jaromir-sukuba/micro_progmeter/README

repository for https://hackaday.io/project/7988-micro-progmeter
HW design files in cadsoft eagle 6 and higher

The whole project is licensed under MIT license, see LICENSE.md file.
