jaromir-sukuba/micro_progmeter/hw/mechanical/stl/4_main.stl

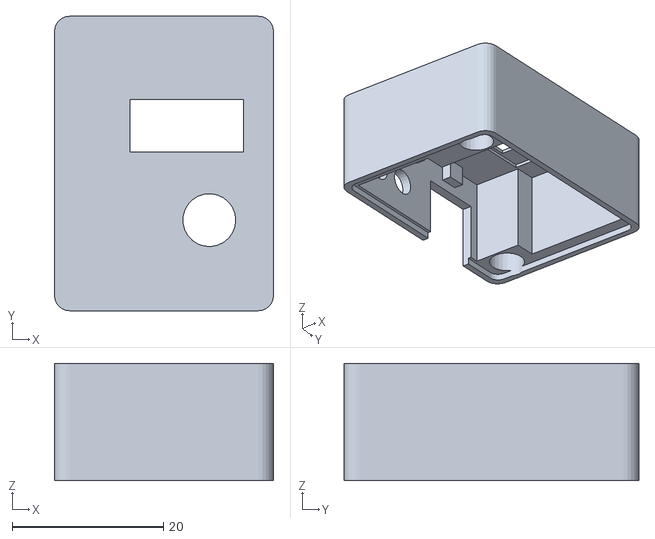
[picture p1: CAD file, 2015-12-22]
hw/mechanical/stl/4_main.stl
29.0 x 39.0 x 15.5
