jaromir-sukuba/micro_progmeter/hw/mechanical/freecad/4.fcstd

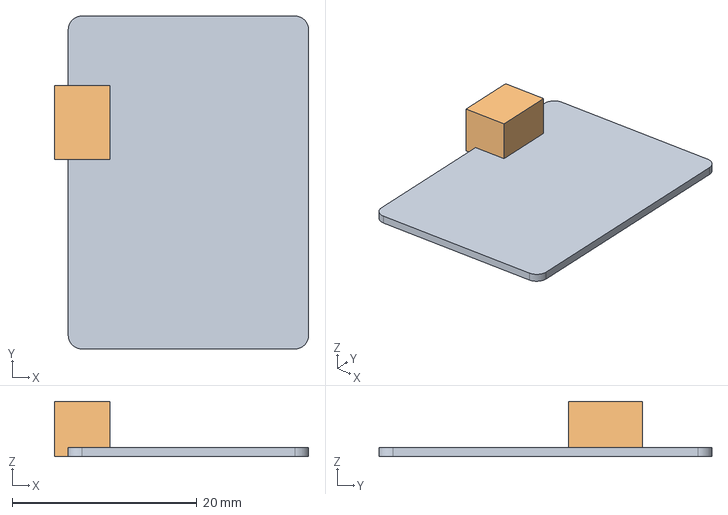
[picture p2: CAD file, 2015-12-22]
hw/mechanical/freecad/4.fcstd
27.5 x 36.0 x 6.00 mm
cover
cover_usb_ext
