jaromir-sukuba/micro_progmeter/hw/mechanical/freecad/4a.fcstd

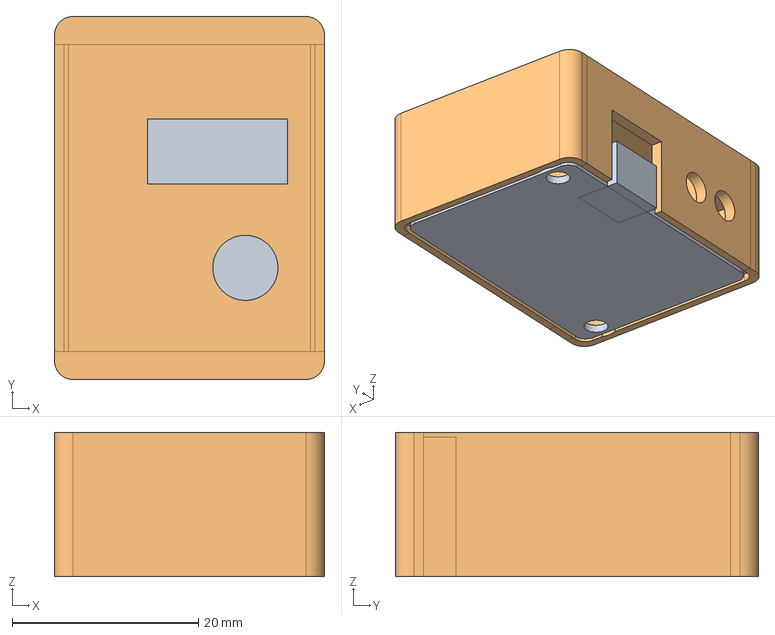
[picture p3: CAD file, 2015-12-22]
hw/mechanical/freecad/4a.fcstd
29.0 x 39.0 x 15.5 mm
cover_holes
main_holes
