jaromir-sukuba/micro_progmeter/hw/mechanical/stl/4_cover.stl

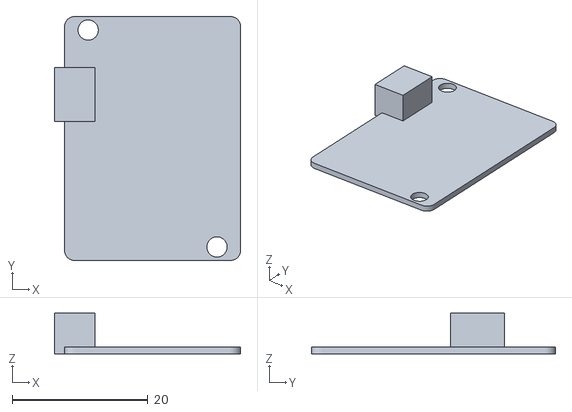
[picture p4: CAD file, 2015-12-22]
hw/mechanical/stl/4_cover.stl
27.5 x 36.0 x 6.00
