jaromir-sukuba/micro_progmeter/(list of files, cad)

Other CAD files:
fw/pmm_t1.X/l.obj
