jaromir-sukuba/micro_progmeter/hw/6e.sch.pdf

TC1015

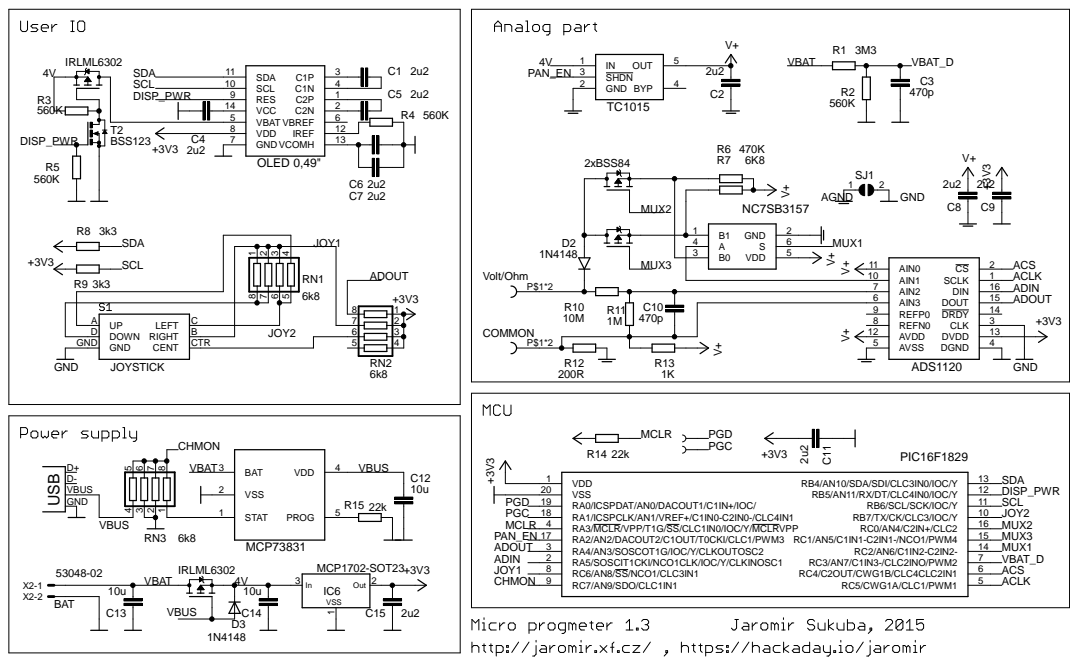
[picture p5: page 1]
