jaromir-sukuba/micro_progmeter/hw/6d.sch.pdf

TC1015

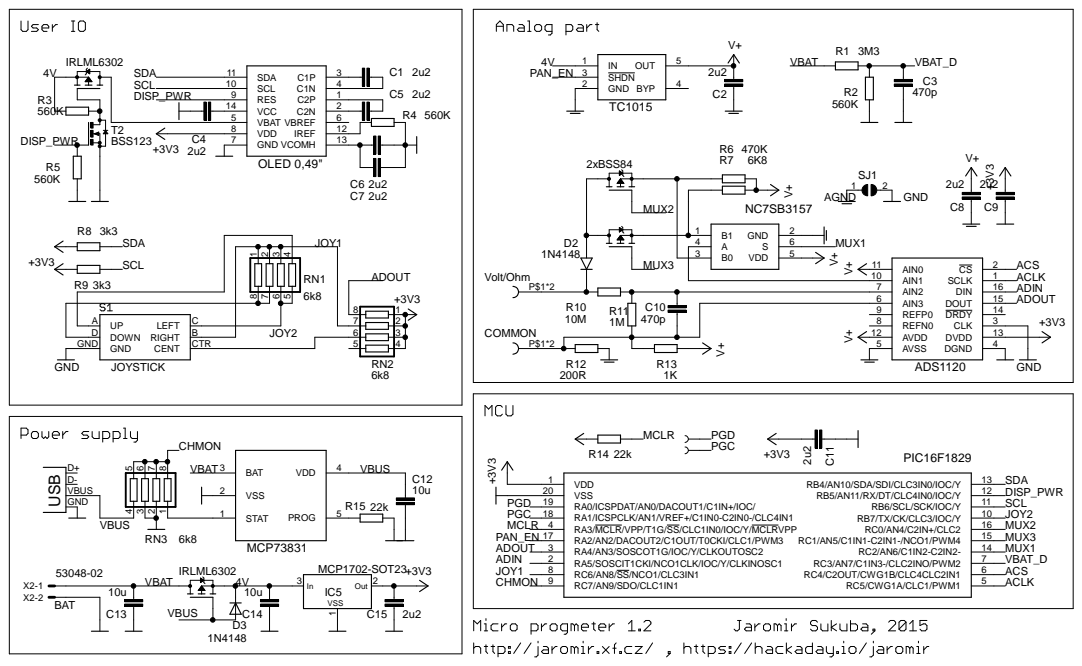
[picture p6: page 1]
