jaromir-sukuba/micro_progmeter/hw/6c.sch.pdf

TC1015

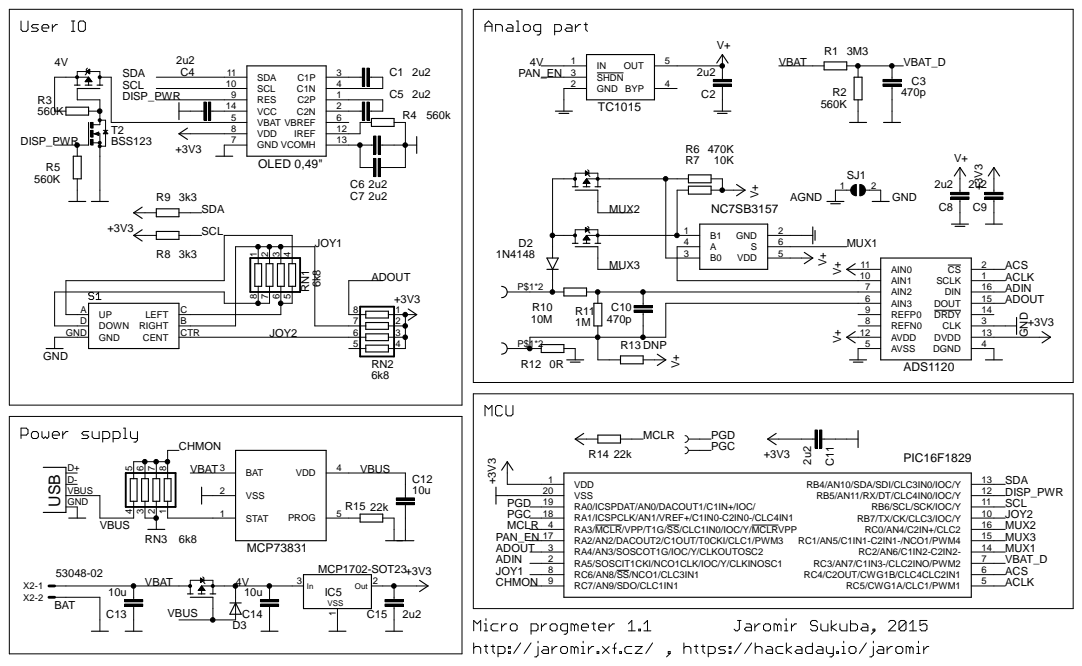
[picture p7: page 1]

VCC 14 | 2
