jaromir-sukuba/micro_progmeter/hw/5d.sch.pdf

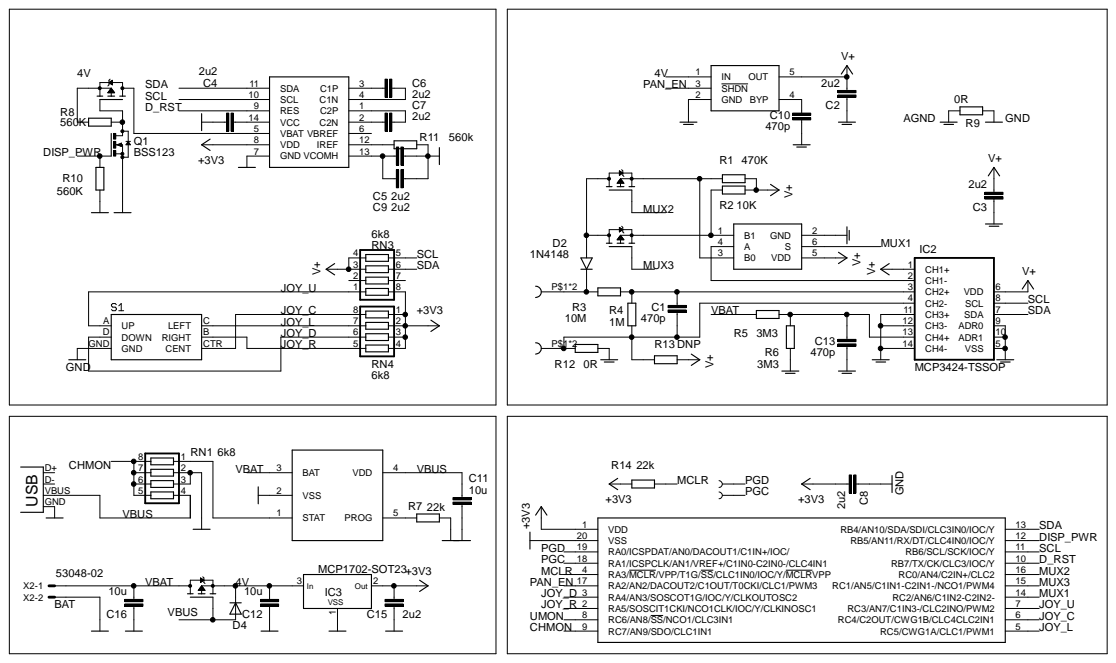
[picture p8: page 1]
