jaromir-sukuba/micro_progmeter/hw/eagle/6e.brd

## EAGLE design hw/eagle/6e.brd (2015-12-22)

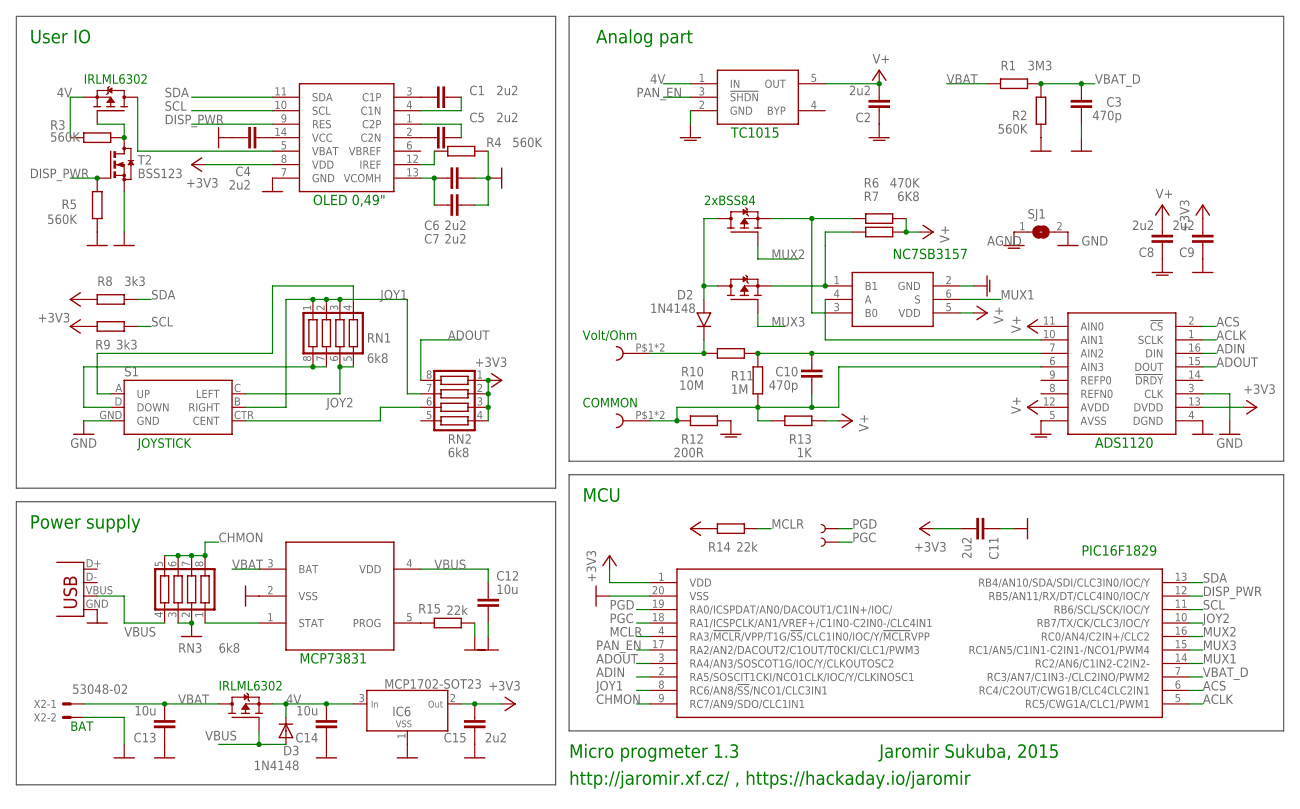
[picture p9: schematic 6e.sch]

Parts:
C1, C2, C4, C5, C6, C7, C8, C9, C11, C15: 2u2; 0603
C3, C10: 470p; 0603
C12, C13, C14: 10u; R0805
D1: DISP_OLED_049B; DISP_OLED_049_B
D2: 1N4148; SOD-80
D3: 1N4148; SOD123
IC1: TC1015; SOT23-5
IC2: NC7SB3157; SC70-6
IC3: ADS1120; TSSOP16
IC4: MCP73831; SOT23-5
IC5: PIC16F1508SSOP20; SSOP20
IC6: MCP1702-SOT23; SOT23
R1: 3M3; 0603
R2, R3, R4, R5: 560K; 0603
R6: 470K; R0805
R7: 6K8; R0805
R8, R9: 3k3; 0603
R10: 10M; R0805
R11: 1M; R0805
R12: 200R; 0603
R13: 1K; 0603
R14, R15: 22k; 0603
RN1, RN2, RN3: 6k8; CTS742C083
S1: JOYSTICK_MINI
SJ1: SJ
T1, T3, T4, T5: BSS84; SOT23-3
T2: BSS123; SOT23
TE1, TE2: BANPLUG_2
TP1, TP2: TEST-POINT3X5; PAD.03X.05
X1: USB-MICROB
X2: 53048-02

Connections:
4V: C14.2, D3.C, IC1.1 (IN), IC6.3 (IN), R3.1, T1.2 (S), T5.2 (S)
+3V3: C9.2, C11.2, C15.2, D1.8 (VDD), IC3.13 (DVDD), IC5.1 (VDD), IC6.2 (OUT), R8.2, R9.2, R14.2, RN2.1, RN2.2, RN2.3, RN2.4
ACLK: IC3.1 (SCLK), IC5.5 (RC5/CWG1A/CLC1/PWM1)
ACS: IC3.2 (!CS), IC5.6 (RC4/C2OUT/CWG1B/CLC4CLC2IN1)
ADIN: IC3.16 (DIN), IC5.2 (RA5/SOSCIT1CKI/NCO1CLK/IOC/Y/CLKINOSC1)
ADOUT: IC3.15 (DOUT), IC5.3 (RA4/AN3/SOSCOT1G/IOC/Y/CLKOUTOSC2), RN2.8
AGND: C2.1, C8.1, IC1.2 (GND), IC2.2 (GND), IC3.5 (AVSS), R12.1, SJ1.1
CHMON: IC5.9 (RC7/AN9/SDO/CLC1IN1), RN3.5, RN3.6, RN3.7, RN3.8
DISP_PWR: D1.9 (RES), IC5.12 (RB5/AN11/RX/DT/CLC4IN0/IOC/Y), R5.2, T2.1 (G)
GND: C3.1, C4.1, C6.2, C7.2, C9.1, C11.1, C12.2, C13.1, C14.1, C15.1, D1.7 (GND), IC3.3 (CLK), IC3.4 (DGND), IC4.2 (VSS), IC5.20 (VSS), IC6.1 (VSS), R2.2, R4.1, R5.1, R15.1, RN3.2, RN3.3, S1.GND, SJ1.2, T2.2 (S), X1.GND, X2.2
JOY1: IC5.8 (RC6/AN8/!SS!/NCO1/CLC3IN1), RN1.1, RN1.2, RN1.3, RN2.7, S1.B (RIGHT)
JOY2: IC5.10 (RB7/TX/CK/CLC3/IOC/Y), RN2.6, S1.CTR (CENT)
MCLR: IC5.4 (RA3/!MCLR!/VPP/T1G/!SS!/CLC1IN0/IOC/Y/!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), R14.1
MUX1: IC2.6 (S), IC5.14 (RC2/AN6/C1IN2-C2IN2-)
MUX2: IC5.16 (RC0/AN4/C2IN+/CLC2), T3.1 (G)
MUX3: IC5.15 (RC1/AN5/C1IN1-C2IN1-/NCO1/PWM4), T4.1 (G)
unnamed: IC2.1 (B1), R7.2, T4.2 (S)
unnamed: IC2.3 (B0), R6.2, T3.2 (S)
unnamed: IC2.4 (A), IC3.10 (AIN1)
unnamed: D2.K, R10.2, TE1.P$1, TE1.P$2
unnamed: R3.2, T1.1 (G), T2.3 (D)
unnamed: C10.2, IC3.7 (AIN2), R10.1, R11.1
unnamed: IC4.1 (STAT), RN3.1
unnamed: C10.1, IC3.6 (AIN3), R11.2, R12.2, R13.1, TE2.P$1, TE2.P$2
unnamed: C4.2, D1.14 (VCC)
unnamed: D1.5 (VBAT), T1.3 (D)
unnamed: C6.1, C7.1, D1.13 (VCOMH)
unnamed: D1.12 (IREF), R4.2
unnamed: D2.A, T3.3 (D), T4.3 (D)
unnamed: RN1.4, S1.A (UP)
unnamed: C1.1, D1.3 (C1P)
unnamed: C5.1, D1.2 (C2N)
unnamed: C5.2, D1.1 (C2P)
unnamed: C1.2, D1.4 (C1N)
unnamed: RN1.5, RN1.6, S1.C (LEFT)
unnamed: RN1.7, RN1.8, S1.D (DOWN)
unnamed: IC4.5 (PROG), R15.2
PAN_EN: IC1.3 (!SHDN), IC5.17 (RA2/AN2/DACOUT2/C1OUT/T0CKI/CLC1/PWM3)
PGC: IC5.18 (RA1/ICSPCLK/AN1/VREF+/C1IN0-C2IN0-/CLC4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), TP2.P$1
PGD: IC5.19 (RA0/ICSPDAT/AN0/DACOUT1/C1IN+/IOC/), TP1.P$1
SCL: D1.10 (SCL), IC5.11 (RB6/SCL/SCK/IOC/Y), R9.1
SDA: D1.11 (SDA), IC5.13 (RB4/AN10/SDA/SDI/CLC3IN0/IOC/Y), R8.1
V+: C2.2, C8.2, IC1.5 (OUT), IC2.5 (VDD), IC3.11 (AIN0), IC3.12 (AVDD), R6.1, R7.1, R13.2
VBAT: C13.2, IC4.3 (BAT), R1.2, T5.3 (D), X2.1
VBAT_D: C3.2, IC5.7 (RC3/AN7/C1IN3-/CLC2INO/PWM2), R1.1, R2.1
VBUS: C12.1, D3.A, IC4.4 (VDD), RN3.4, T5.1 (G), X1.VBUS

Notes on the sheet:
BAT
Micro progmeter 1.3
Jaromir Sukuba, 2015
http://jaromir.xf.cz/ , https://hackaday.io/jaromir
User IO
Analog part
Power supply
MCU
ADS1120
OLED 0,49"
MCP73831
TC1015
PIC16F1829
NC7SB3157
Volt/Ohm
COMMON
2xBSS84
JOYSTICK
IRLML6302

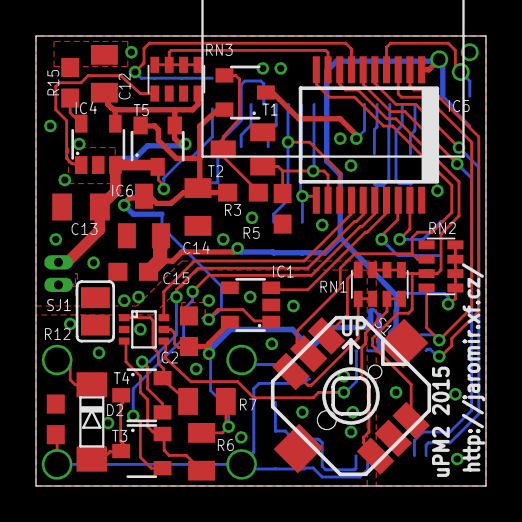
[picture p10: board 6e.brd from above]

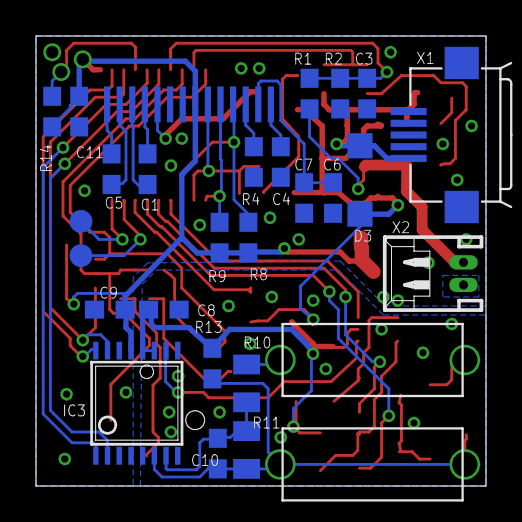
[picture p11: board 6e.brd from below]

Board: 2 copper layers, 25.0 x 25.0 mm, 55 parts (27 on the bottom side), 46 nets.
