jaromir-sukuba/micro_progmeter/fw/pmm_t1.X/helper.h

long powd(int a, int b);
unsigned char intToStr(int x, char str[], unsigned char d);
unsigned char xftoa(float n, char *res, unsigned char bpoint, unsigned char apoint);
void reverse(char *str, int len);
