jaromir-sukuba/micro_progmeter/(commit log)

2015-10-08 hardware rev 1
    [5d.brd, 5d.sch]
2015-10-09 PCB ver 1.1
    minor cleanup
    [5d.brd, 5d.sch]
2015-12-01 gerber data
    gerber data
    [6c.GBL, 6c.GBO, 6c.GBP, 6c.GBS, 6c.GTL, 6c.GTO, 6c.GTP, 6c.GTS]
2015-12-02 files cleanup
    files cleanup
    [5d.brd, 5d.sch, 6c.brd, 6c.sch]
2015-12-07 bom, version 1
    bom, version 1
2015-12-07 bom, version 2
    bom, version 2
    [bom.csv]
2015-12-07 BOM updated to correct CSV
    BOM updated to correct CSV
    [bom.csv]
2015-12-08 firmware rev. 1
    firmware rev. 1
    [l.obj]
2015-12-09 testing release
    testing release
    [l.obj]
2015-12-16 firmware rev 2, mechanical files
    firmware rev 2, mechanical files
    [3.FCStd, 3a.FCStd, 3a_cover.stl, 3a_main.stl]
2015-12-16 BOM 2
    BOM 2
    [6d.csv]
2015-12-16 BOM 2
    BOM2
    [6d_.csv]
2015-12-16 BOM2
    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
    [6d__.csv]
2015-12-16 schematics cleanup, bom update
    schematics cleanup, bom update
    [6d.csv, 6d2_.csv, 6d_.csv, 6d__.csv, bom.csv]
2015-12-16 BOM update
    BOM update
    [bom.csv]
2015-12-16 schematics cleanup
    schematics cleanup
    [6d.brd, 6d.sch]
2015-12-22 final release
    final release
    [3.FCStd, 3a.FCStd, 3a_cover.stl, 3a_main.stl, 4.fcstd, 4_cover.stl, 4_main.stl, 4a.fcstd]
2015-12-22 final BOM
    final BOM
    [BOMx.csv, bom.csv]
2015-12-23 calibration coefficients update
    calibration coefficients update
    [l.obj]
2015-12-25 BOM update
    changed PIC16F1508 to 16LF1829
    [bom.csv]
